philpem/GnomeComp_TransputerLinkPodule/LinkAdapter/README.md

# Gnome Computers Transputer Link Podule recreation

Phil Pemberton, Feb 2026.

This is a recreation of the Transputer Link Podule by Gnome Computers Ltd.

The PLD equations were initially created by inference from the reverse-engineered schematic, but Chris of Gnome Computers later provided the original programming files in PLPL format.
The current WinCUPL equations are based on my reverse-engineered ones, but incorporate the corrected logic from the original PAL equations.

Thanks are due to Chris Stenton of the former Gnome Computers Ltd., who graciously dug into his archives to find some blank PCBs and the PAL/PROM programming files, which were used to build this.

## Files included

  * `doc/*`: Documentation in GCAL and PDF format.
  * `kicad/*`: KiCAD schematic and PCB files, reverse-engineered from scans of the original PCB.
  * `lap.{bin,hex}`: IC3 (82S123 PROM) data -- original from Gnome. TPROD identifies this as a Transputer Link, serial number 47.
  * `ic4/lap11.{pld,jed,wcp}`: IC4 logic equations in WinCUPL format.
  * `ic4_orig`: IC4 logic equations for PAL16L8 -- original from Gnome. Format unknown.

## Assembly instructions

This is a fairly straightforward build, but has some unusual parts.
The Inmos C012 link adapter chip might be tricky to find, but the C011 can be used instead by fitting a larger socket in the IC7 footprint.

There are two programmable devices:

  * IC3: 82S123N PROM, 32*8-bit wide = 256 bit.
    * Substitutes: MMI 6331-1, 63S081 or 63LS081. TI TBP18S030. Harris HM7603-5. AMD AM27S19, AM27S19AC, AM27S09 or AM27LS09. National 74S2788.
  * IC4: TIBPAL16L8-25 PAL.
    * Substitutes: ATF16V8 or GAL16V8.

The 82S123 PROM has a number of substitutes, but finding a programmer which can program them might be tricky. If all else fails, the PROM can be replaced with another GAL in a socket adapter. This is left as an exercise to the reader, but [Mark Haysman's article on a 'reprogrammable 82S123'](http://www.retroclinic.com/leopardcats/galprom/galprom.htm) will probably be helpful.

The bipolar PROM cross-references I use are:

  * https://www.pe1abr.nl/pdf/TTL-BIPOLAR_PROM-RAM_REFERENCE_GUIDE_V5.pdf
  * http://matthieu.benoit.free.fr/cross/data_sheets/NS_bipolar_.prom_cross_reference_guide.pdf
  * https://www.mikesarcade.com/cgi-bin/spies.cgi?action=url&type=info&page=PromRef.txt

### IC3: Podule ID PROM.

The PROM has A3 grounded, and A4 is driven by the PAL to indicate an interrupt is being signalled.
This means that only two banks of 8 bytes are ever addressed.

The Podule ID is an old-style ID (not an ECID) and decodes as follows:

```
0:  &00  - (&01 if generating IRQ)
1:  (reserved)
2:  (reserved)
3:  &24  - Product type low
4:  &00  - Product type high
5:  &0E  - Manufacturer low
6:  &00  - Manufacturer high
7:  &00  - Country code
```

The PAL data seems to use A3 to indicate FIQ status (1=FIQ active), but the Link Podule doesn't use FIQs.

There are also two bytes programmed in locations 1 and 2 which are the same in every copy. These areas are marked Reserved in the Podule specification, so should be programmed to zero!  I suspect this might be related to the copy-protection on some of the Gnome software.

The image from Gnome is identified by their `TPROD` utility as having serial number 47. I suspect this is encoded into the second and third bytes of the Podule ID PROM:

```
0000: 00 f0 02 24 00 0e 00 00
0008: 04 f0 02 24 00 0e 00 00
0010: 01 f0 02 24 00 0e 00 00
0018: 05 f0 02 24 00 0e 00 00
         ^  ^^

Serial number 47 = &2F => stored in the upper 12 bits of a ui16le at prom[1].

This leaves bits W[1:0] (code width), IS (interrupt status relocation) and CD (chunks present) clear.
```

These are then converted into licence keys or "Podule keys" which are checked by `afserver`, `nbserver` and `Server14`, and can be generated with Kobold (see above).

### IC4: Address decoder PAL.

This is a PAL16L8 in the original design, but it can be replaced with a GAL16V8. If you use a PAL16L8, program it with the original Gnome Computers JEDEC file. If you use a GAL16V8, use my recreated WinCUPL programming files.

25ns speed grade is plenty fast enough. I used a 10ns chip and it worked fine.

## Bill of Materials and assembly notes

This is the original BOM given to me by Gnome Computers.

A few notes on part substitutions:

  * IC5 may be an Inmos IMSC012, but the larger footprint will take the more easily obtained IMSC011.
  * C1 (1uF monolithic multilayer ceramic) is critical, as it's the filter capacitor for the link chip's internal PLL.
  * C2 and C3 are fairly non-critical. I've used 10uF electrolytics.
  * C4 thru C11 are also fairly non-critical. I used 100nF 63V metallised polyester film capacitors, Arcotronics (now Yageo/Kemet) R82DC3100DQ50J.
  * The pitch for all the non-polarised capacitors is 5mm.

J2 needs some care. A 5-pin header is fitted at each end of the 12-pin connector, with the middle 2 pins empty. The left header should have pins 1 and 5 grounded, and pin 2 is removed. If you look at the PCB, you'll see that pin 2 has nothing connected to it. Pin 1 of J2 is nearest the crystal oscillator.

```
           Link Adapter Board, Issue 1
           ===========================

Part    Description                       Source      Order Code   Price

R1      100R 0.25W 5% carbon film         Farnell     DCR25 100R   0.0124 (100)
R2      10K          "                    Farnell     DCR25 10K    0.0124 (100)
R3      100K         "                    Farnell     DCR25 100K   0.0124 (100)

C1      1u0 ceramic multilayer            Farnell     146-235      0.267  (100)
C2-3    6.8uF 16V tantalum bead           STC         015772R      0.09   (100)
C4-11   10nF 63V ceramic plate            Farnell     629 19103    0.04   (100)

IC1-2   74HCT245                          Quarndon    SN74HCT245N  0.34   (10)
IC3     N82S123AN                         Quarndon    <---         0.86   (10)
IC4     TIBPAL16L8-25                     Quarndon    <---         1.20   (10)
IC5     IMSC012-P20S                      Anzac etc   <---         5.31   (1)
IC6     5MHz crystal oscillator           ACT         ACT1100 5MHz 2.75   (10)
IC7     74HCT175                          Quarndon    PC74HCT175P  0.32   (10)
IC8     74HCT244                          Quarndon    SN74HCT244N  0.31   (10)

J1      64 way DIN 41612 plug             Farnell     104-985      1.03   (1)
J2      5 way Molex header (2 off)        Farnell     146-694      0.312  (1)

Other parts

Socket  20 way (IC8)                      Farnell     178-858      0.1175 (20)
PCB     Link Adapter Board (Issue 1)      Camb Cct Co <---         18.43  (10)
Board mounts (1 pack of 2)                Verospeed   173-12525B   0.40   (10)
Panel   Link Adapter Panel                Entec       <---         2.18   (25)
Nuts    M2.5 (4 off)                      Farnell     149-679      0.0065 (100)
Bolts   M2.5 10mm (4 off)                 Farnell     149-462      0.0074 (100)

PALS    IC4  LAP11.JED
PROMS   IC3  LAP.HEX
```
