philpem/GnomeComp_TransputerLinkPodule/LinkAdapter/kicad/linkpodule.kicad_pcb

## KiCad design LinkAdapter/kicad/linkpodule.kicad_pcb (2026-02-23)

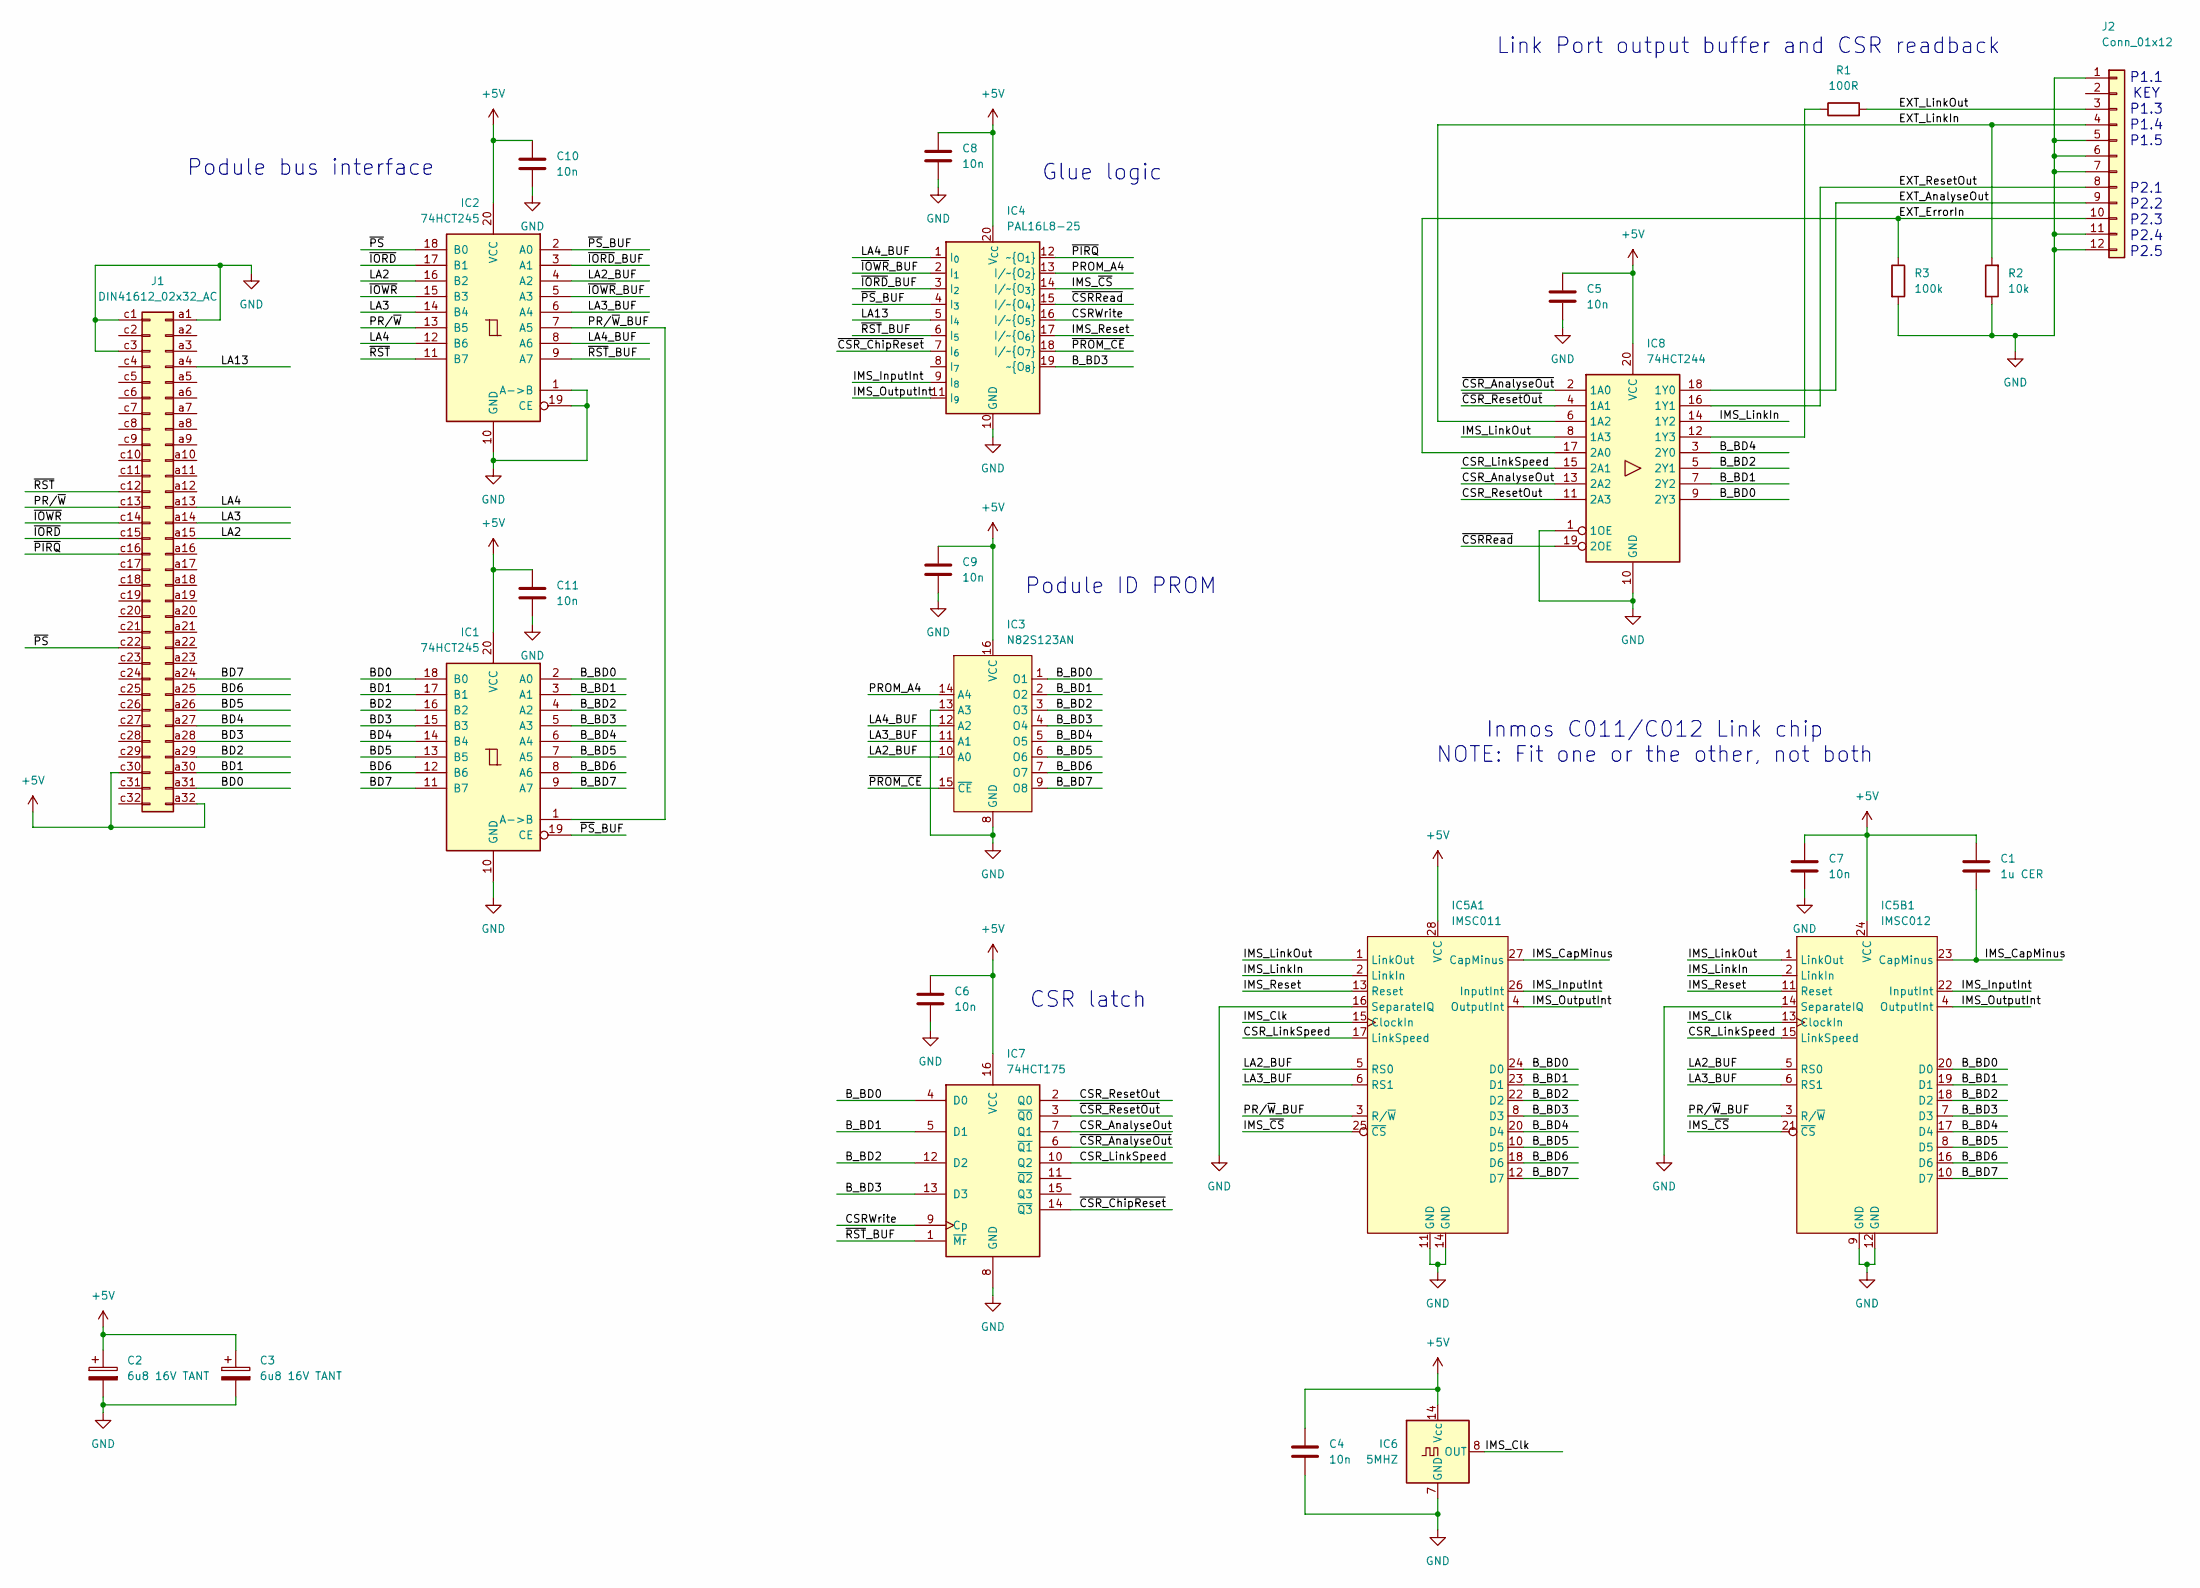
[picture p1: schematic linkpodule.kicad_sch, TRANSPUTER LINK PODULE]

Parts:
C1: 1u CER; C_Disc_D4.3mm_W1.9mm_P5.00mm
C2, C3: 6u8 16V TANT; CP_Radial_Tantal_D8.0mm_P5.00mm
C4, C5, C6, C7, C8, C9, C10, C11: 10n; C_Disc_D4.3mm_W1.9mm_P5.00mm
IC1, IC2: 74HCT245; DIP-20_W7.62mm
IC3: N82S123AN; DIP-16_W7.62mm
IC4: PAL16L8-25; DIP-20_W7.62mm
IC5A1: IMSC011; DIP-28_W15.24mm
IC5B1: IMSC012; DIP-24_W7.62mm
IC6: 5MHZ; Oscillator_DIP-14
IC7: 74HCT175; DIP-16_W7.62mm
IC8: 74HCT244; DIP-20_W7.62mm
J1: DIN41612_02x32_AC; DIN41612_C_2x32_Male_Horizontal_THT
J2: Conn_01x12; PinHeader_1x12_P2.54mm_Horizontal
R1: 100R; R_Axial_DIN0207_L6.3mm_D2.5mm_P10.16mm_Horizontal
R2: 10k; R_Axial_DIN0207_L6.3mm_D2.5mm_P10.16mm_Horizontal
R3: 100k; R_Axial_DIN0207_L6.3mm_D2.5mm_P10.16mm_Horizontal

Connections:
+5V: C1.1, C2.1, C3.1, C4.1, C5.1, C6.1, C7.1, C8.1, C9.1, C10.1, C11.1, IC1.20 (VCC), IC2.20 (VCC), IC3.16 (VCC), IC4.20 (V_{CC}), IC5A1.28 (VCC), IC5B1.24 (VCC), IC6.14 (Vcc), IC7.16 (VCC), IC8.20 (VCC), J1.a32, J1.c30
/BD0: IC1.18 (B0), J1.a31
/BD1: IC1.17 (B1), J1.a30
/BD2: IC1.16 (B2), J1.a29
/BD3: IC1.15 (B3), J1.a28
/BD4: IC1.14 (B4), J1.a27
/BD5: IC1.13 (B5), J1.a26
/BD6: IC1.12 (B6), J1.a25
/BD7: IC1.11 (B7), J1.a24
/B_BD0: IC1.2 (A0), IC3.1 (O1), IC5A1.24 (D0), IC5B1.20 (D0), IC7.4 (D0), IC8.9 (2Y3)
/B_BD1: IC1.3 (A1), IC3.2 (O2), IC5A1.23 (D1), IC5B1.19 (D1), IC7.5 (D1), IC8.7 (2Y2)
/B_BD2: IC1.4 (A2), IC3.3 (O3), IC5A1.22 (D2), IC5B1.18 (D2), IC7.12 (D2), IC8.5 (2Y1)
/B_BD3: IC1.5 (A3), IC3.4 (O4), IC4.19 (~O_{8}), IC5A1.8 (D3), IC5B1.7 (D3), IC7.13 (D3)
/B_BD4: IC1.6 (A4), IC3.5 (O5), IC5A1.20 (D4), IC5B1.17 (D4), IC8.3 (2Y0)
/B_BD5: IC1.7 (A5), IC3.6 (O6), IC5A1.10 (D5), IC5B1.8 (D5)
/B_BD6: IC1.8 (A6), IC3.7 (O7), IC5A1.18 (D6), IC5B1.16 (D6)
/B_BD7: IC1.9 (A7), IC3.9 (O8), IC5A1.12 (D7), IC5B1.10 (D7)
/CSRWrite: IC4.16 (I/~O_{5}), IC7.9 (Cp)
/CSR_AnalyseOut: IC7.7 (Q1), IC8.13 (2A2)
/CSR_LinkSpeed: IC5A1.17 (LinkSpeed), IC5B1.15 (LinkSpeed), IC7.10 (Q2), IC8.15 (2A1)
/CSR_ResetOut: IC7.2 (Q0), IC8.11 (2A3)
/EXT_AnalyseOut: IC8.18 (1Y0), J2.9
/EXT_ErrorIn: IC8.17 (2A0), J2.10, R3.1
/EXT_LinkIn: IC8.6 (1A2), J2.4, R2.2
/EXT_LinkOut: J2.3, R1.2
/EXT_ResetOut: IC8.16 (1Y1), J2.8
/IMS_CapMinus: C1.2, IC5A1.27 (CapMinus), IC5B1.23 (CapMinus)
/IMS_Clk: IC5A1.15 (ClockIn), IC5B1.13 (ClockIn), IC6.8 (OUT)
/IMS_InputInt: IC4.9 (I_{8}), IC5A1.26 (InputInt), IC5B1.22 (InputInt)
/IMS_LinkIn: IC5A1.2 (LinkIn), IC5B1.2 (LinkIn), IC8.14 (1Y2)
/IMS_LinkOut: IC5A1.1 (LinkOut), IC5B1.1 (LinkOut), IC8.8 (1A3)
/IMS_OutputInt: IC4.11 (I_{9}), IC5A1.4 (OutputInt), IC5B1.4 (OutputInt)
/IMS_Reset: IC4.17 (I/~O_{6}), IC5A1.13 (Reset), IC5B1.11 (Reset)
/IMS_~CS: IC4.14 (I/~O_{3}), IC5A1.25 (~CS), IC5B1.21 (~CS)
/LA2: IC2.16 (B2), J1.a15
/LA2_BUF: IC2.4 (A2), IC3.10 (A0), IC5A1.5 (RS0), IC5B1.5 (RS0)
/LA3: IC2.14 (B4), J1.a14
/LA3_BUF: IC2.6 (A4), IC3.11 (A1), IC5A1.6 (RS1), IC5B1.6 (RS1)
/LA4: IC2.12 (B6), J1.a13
/LA4_BUF: IC2.8 (A6), IC3.12 (A2), IC4.1 (I_{0})
/LA13: IC4.5 (I_{4}), J1.a4
/PROM_A4: IC3.14 (A4), IC4.13 (I/~O_{2})
/PR/~W: IC2.13 (B5), J1.c13
/PR/~W_BUF: IC1.1 (A->B), IC2.7 (A5), IC5A1.3 (R/~W), IC5B1.3 (R/~W)
/~CSRRead: IC4.15 (I/~O_{4}), IC8.19 (2OE)
/~CSR_AnalyseOut: IC7.6 (~Q1), IC8.2 (1A0)
/~CSR_ChipReset: IC4.7 (I_{6}), IC7.14 (~Q3)
/~CSR_ResetOut: IC7.3 (~Q0), IC8.4 (1A1)
/~IORD: IC2.17 (B1), J1.c15
/~IORD_BUF: IC2.3 (A1), IC4.3 (I_{2})
/~IOWR: IC2.15 (B3), J1.c14
/~IOWR_BUF: IC2.5 (A3), IC4.2 (I_{1})
/~PIRQ: IC4.12 (~O_{1}), J1.c16
/~PROM_CE: IC3.15 (~CE), IC4.18 (I/~O_{7})
/~PS: IC2.18 (B0), J1.c22
/~PS_BUF: IC1.19 (CE), IC2.2 (A0), IC4.4 (I_{3})
/~RST: IC2.11 (B7), J1.c12
/~RST_BUF: IC2.9 (A7), IC4.6 (I_{5}), IC7.1 (~Mr)
GND: C2.2, C3.2, C4.2, C5.2, C6.2, C7.2, C8.2, C9.2, C10.2, C11.2, IC1.10 (GND), IC2.1 (A->B), IC2.10 (GND), IC2.19 (CE), IC3.8 (GND), IC3.13 (A3), IC4.10 (GND), IC5A1.11 (GND), IC5A1.14 (GND), IC5A1.16 (SeparateIQ), IC5B1.9 (GND), IC5B1.12 (GND), IC5B1.14 (SeparateIQ), IC6.7 (GND), IC7.8 (GND), IC8.1 (1OE), IC8.10 (GND), J1.a1, J1.c1, J1.c3, J2.1, J2.5, J2.6, J2.7, J2.11, J2.12, R2.1, R3.2
unnamed: IC8.12 (1Y3), R1.1

Notes on the sheet:
Podule ID PROM
Podule bus interface
Glue logic
CSR latch
Link Port output buffer and CSR readback
Inmos C011/C012 Link chip NOTE: Fit one or the other, not both
P1.1 KEY P1.3 P1.4 P1.5 P2.1 P2.2 P2.3 P2.4 P2.5

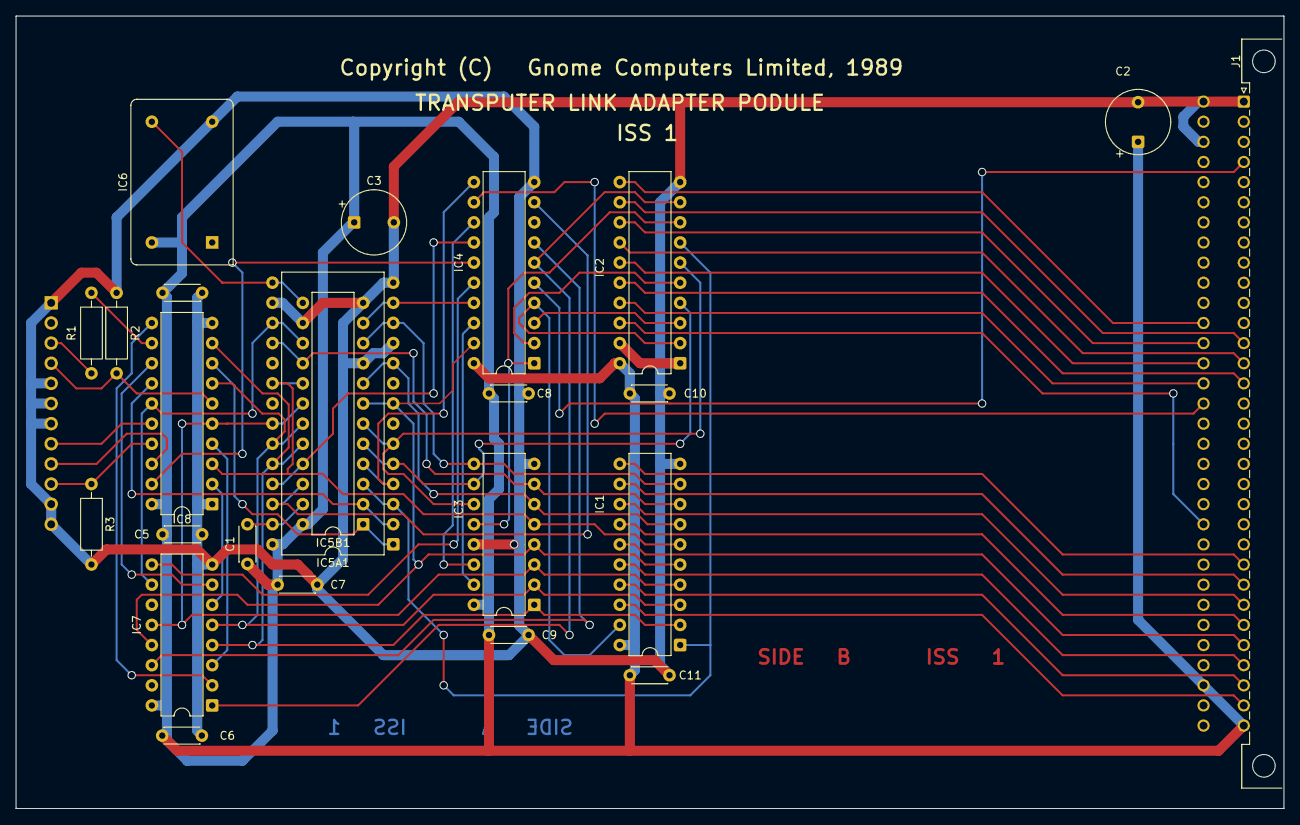
[picture p2: board linkpodule.kicad_pcb from above]

Board: 2 copper layers, 160.0 x 100.0 mm, 25 parts (1 on the bottom side), 60 nets.
