philpem/GnomeComp_TransputerLinkPodule/(commit log)

2026-02-23 kicad: Add missing D3 connection on PAL
    [linkpodule.kicad_pcb, linkpodule.kicad_sch]
2026-04-16 Move Link Adapter files into a subdirectory
    [linkpodule.kicad_pcb, linkpodule.kicad_sch]
2026-04-16 Add TRAM Podule docs
    [trampod.g]
