philpem/GnomeComp_TransputerLinkPodule/(notices)

Notices in the files:
LinkAdapter/kicad/linkpodule.kicad_pcb:
Copyright (C) Gnome Computers Limited, 1989
